alinxalinx/ACU2CG_ACU3EG_ACU4EV_ACU5EV/Pictures/ACU2CG_T.jpg

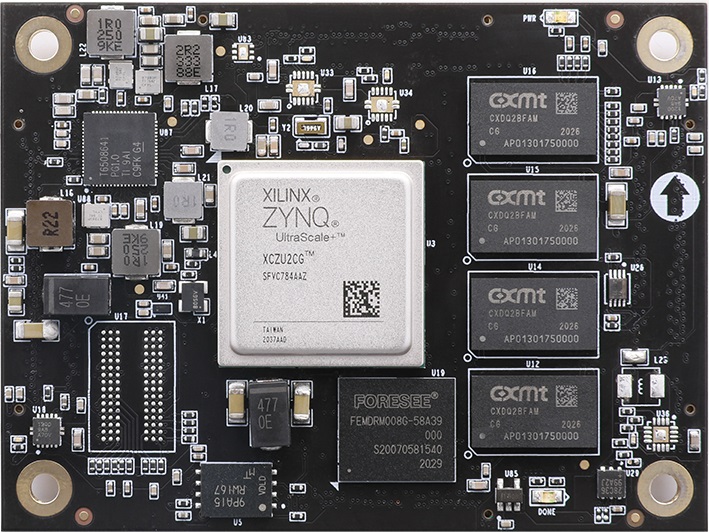
Pictures/ACU2CG_T.jpg
