alinxalinx/ACU2CG_ACU3EG_ACU4EV_ACU5EV/Pictures/ACU3EG_T.jpg

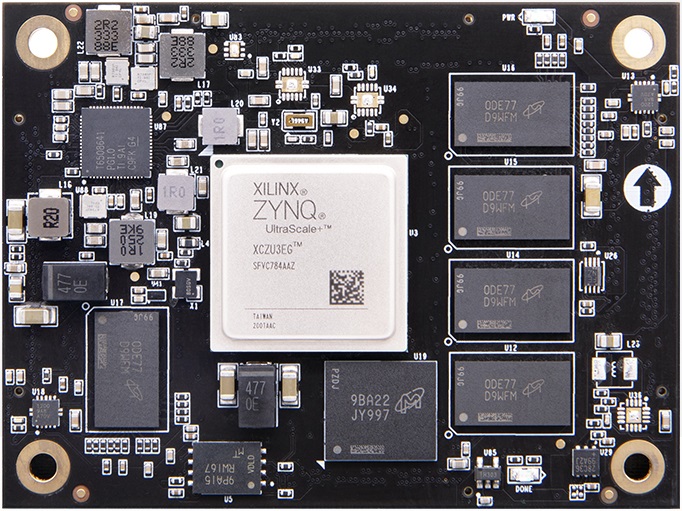
Pictures/ACU3EG_T.jpg
