alinxalinx/ACU2CG_ACU3EG_ACU4EV_ACU5EV/Pictures/ACU4EV_T.jpg

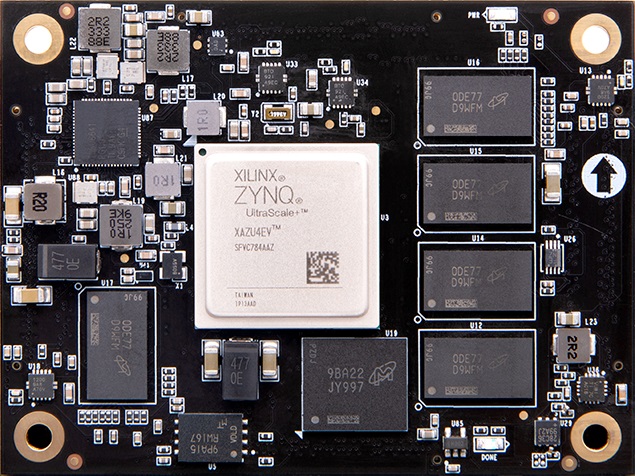
Pictures/ACU4EV_T.jpg
