alinxalinx/ACU2CG_ACU3EG_ACU4EV_ACU5EV/Trace_Lengths/IO_Length-acu2cg-2018-11-7.xls

Sheet: 505
Name | Pin Number | Singals | Min Trace Delay (ps) | Max Trace Delay (ps) | Delay(mils) | Board Length(mils) | Total Length(mils)
505_CLK0_N | F24 | PS_MGTREFCLK0N_505 | 77.181 | 77.957 | 448.3757225 | 757.06 | 1205.435723
505_CLK0_P | F23 | PS_MGTREFCLK0P_505 | 76.704 | 77.474 | 445.6011561 | 757.95 | 1203.551156
 |  |  |  |  | 0 |  | 0
505_CLK1_N | E22 | PS_MGTREFCLK1N_505 | 76.161 | 76.927 | 442.4508671 | 1082.16 | 1524.610867
505_CLK1_P | E21 | PS_MGTREFCLK1P_505 | 75.712 | 76.473 | 439.8410405 | 1083.04 | 1522.88104
 |  |  |  |  | 0 |  | 0
505_CLK2_N | C22 | PS_MGTREFCLK2N_505 | 86.316 | 87.183 | 501.4421965 | 818.31 | 1319.752197
505_CLK2_P | C21 | PS_MGTREFCLK2P_505 | 85.985 | 86.85 | 499.5231214 | 820.89 | 1320.413121
 |  |  |  |  | 0 |  | 0
505_CLK3_N | A22 | PS_MGTREFCLK3N_505 | 87.98 | 88.864 | 511.1098266 | 776.57 | 1287.679827
505_CLK3_P | A21 | PS_MGTREFCLK3P_505 | 87.717 | 88.599 | 509.583815 | 777.25 | 1286.833815
 |  |  |  |  | 0 |  | 0
505_RX0_N | F28 | PS_MGTRRXN0_505 | 98.87 | 99.864 | 574.3757225 | 1007.78 | 1582.155723
505_RX0_P | F27 | PS_MGTRRXP0_505 | 98.768 | 99.761 | 573.783237 | 1007.89 | 1581.673237
 |  |  |  |  | 0 |  | 0
505_RX1_N | D28 | PS_MGTRRXN1_505 | 111.581 | 112.702 | 648.216763 | 890.97 | 1539.186763
505_RX1_P | D27 | PS_MGTRRXP1_505 | 111.619 | 112.741 | 648.4393064 | 889.86 | 1538.299306
 |  |  |  |  |  |  | 0
505_RX2_N | B28 | PS_MGTRRXN2_505 | 105.44 | 106.5 | 612.5433526 | 676.91 | 1289.453353
505_RX2_P | B27 | PS_MGTRRXP2_505 | 105.488 | 106.548 | 612.8208092 | 676.28 | 1289.100809
 |  |  |  |  | 0 |  | 0
505_RX3_N | A26 | PS_MGTRRXN3_505 | 95.579 | 96.539 | 555.2543353 | 582.26 | 1137.514335
505_RX3_P | A25 | PS_MGTRRXP3_505 | 95.598 | 96.559 | 555.367052 | 582.16 | 1137.527052
 |  |  |  |  |  |  | 0
505_TX0_N | E26 | PS_MGTRTXN0_505 | 90.966 | 91.88 | 528.4566474 | 927.74 | 1456.196647
505_TX0_P | E25 | PS_MGTRTXP0_505 | 91.071 | 91.986 | 529.066474 | 929.02 | 1458.086474
 |  |  |  |  | 0 |  | 0
505_TX1_N | D24 | PS_MGTRTXN1_505 | 73.273 | 74.009 | 425.6705202 | 896.87 | 1322.54052
505_TX1_P | D23 | PS_MGTRTXP1_505 | 73.318 | 74.055 | 425.933526 | 897.93 | 1323.863526
 |  |  |  |  | 0 |  | 0
505_TX2_N | C26 | PS_MGTRTXN2_505 | 94.729 | 95.681 | 550.3179191 | 714.96 | 1265.277919
505_TX2_P | C25 | PS_MGTRTXP2_505 | 94.899 | 95.853 | 551.3063584 | 713.23 | 1264.536358
 |  |  |  |  | 0 |  | 0
505_TX3_N | B24 | PS_MGTRTXN3_505 | 88.328 | 89.216 | 513.132948 | 622.28 | 1135.412948
505_TX3_P | B23 | PS_MGTRTXP3_505 | 88.216 | 89.103 | 512.482659 | 621.8 | 1134.282659
 |  |  |  |  |  |  | 0
 |  |  |  |  | 0 |  | 0
差分P和N之间要做等长，等长控制在2mil以内。
差分对之间间隔尽量要远，最好要在30mil以上。
拐弯的地方走成弧形。

Sheet: BANK65
Name | Pin Number | Singals | Min Trace Delay (ps) | Max Trace Delay (ps) | Delay(mils) | Board Length(mils) | Total Length(mils)
B65_L1_N | Y8 | IO_L1N_T0L_N1_DBC_65 | 119.32 | 120.52 | 693.1791908 | 1494.61 | 2187.789191
B65_L1_P | W8 | IO_L1P_T0L_N0_DBC_65 | 118.959 | 120.155 | 691.0809249 | 1498.37 | 2189.450925
B65_L2_N | V9 | IO_L2N_T0L_N3_65 | 103.412 | 104.451 | 600.7601156 | 1560.97 | 2161.730116
B65_L2_P | U9 | IO_L2P_T0L_N2_65 | 111.487 | 112.607 | 647.6705202 | 1510.68 | 2158.35052
B65_L3_N | V8 | IO_L3N_T0L_N5_AD15N_65 | 109.619 | 110.721 | 636.8208092 | 1552.17 | 2188.990809
B65_L3_P | U8 | IO_L3P_T0L_N4_AD15P_65 | 112.8 | 113.933 | 655.2976879 | 1536.31 | 2191.607688
B65_L4_N | T8 | IO_L4N_T0U_N7_DBC_AD7N_65 | 107.023 | 108.099 | 621.7398844 | 1519.43 | 2141.169884
B65_L4_P | R8 | IO_L4P_T0U_N6_DBC_AD7P_SMBALERT_65 | 108.038 | 109.124 | 627.6358382 | 1513.3 | 2140.935838
B65_L5_N | T7 | IO_L5N_T0U_N9_AD14N_65 | 92.383 | 93.312 | 536.6907514 | 1527.99 | 2064.680751
B65_L5_P | R7 | IO_L5P_T0U_N8_AD14P_65 | 93.13 | 94.066 | 541.0289017 | 1524.2 | 2065.228902
B65_L6_N | T6 | IO_L6N_T0U_N11_AD6N_65 | 92.642 | 93.574 | 538.1965318 | 1471.18 | 2009.376532
B65_L6_P | R6 | IO_L6P_T0U_N10_AD6P_65 | 92.461 | 93.391 | 537.1445087 | 1469.03 | 2006.174509
B65_L7_N | K1 | IO_L7N_T1L_N1_QBC_AD13N_65 | 92.343 | 93.271 | 536.4566474 | 1479.54 | 2015.996647
B65_L7_P | L1 | IO_L7P_T1L_N0_QBC_AD13P_65 | 92.939 | 93.873 | 539.9190751 | 1479.45 | 2019.369075
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
B65_L24_N | H8 | IO_L24N_T3U_N11_PERSTN0_65 | 87.942 | 88.826 | 510.8901734 | 1596.2 | 2107.090173
B65_L24_P | H9 | IO_L24P_T3U_N10_PERSTN1_I2C_SDA_65 | 97.353 | 98.331 | 565.5606936 | 1543.53 | 2109.090694
差分P和N之间要做等长，等长控制在5mil以内。
B65的信号做等长，等长在300mil以内

Sheet: BANK66
Name | Pin Number | Singals | Min Trace Delay (ps) | Max Trace Delay (ps) | Delay(mils) | Board Length(mils) | Total Length(mils)
B66_L1_N | F1 | IO_L1N_T0L_N1_DBC_66 | 83.127 | 83.963 | 482.9190751 | 1164.22 | 1647.139075
B66_L1_P | G1 | IO_L1P_T0L_N0_DBC_66 | 82.163 | 82.988 | 477.3150289 | 1166.22 | 1643.535029
B66_L2_N | D1 | IO_L2N_T0L_N3_66 | 90.433 | 91.342 | 525.3612717 | 1122.8 | 1648.161272
B66_L2_P | E1 | IO_L2P_T0L_N2_66 | 87.907 | 88.791 | 510.6878613 | 1141.44 | 1652.127861
B66_L3_N | E2 | IO_L3N_T0L_N5_AD15N_66 | 94.435 | 95.384 | 548.6098266 | 1144.56 | 1693.169827
B66_L3_P | F2 | IO_L3P_T0L_N4_AD15P_66 | 101.121 | 102.138 | 587.4537572 | 1101.91 | 1689.363757
B66_L4_N | F3 | IO_L4N_T0U_N7_DBC_AD7N_66 | 77.616 | 78.396 | 450.9017341 | 1177.86 | 1628.761734
B66_L4_P | G3 | IO_L4P_T0U_N6_DBC_AD7P_66 | 78.429 | 79.217 | 455.6242775 | 1175.58 | 1631.204277
B66_L5_N | E3 | IO_L5N_T0U_N9_AD14N_66 | 80.142 | 80.947 | 465.5751445 | 1216.81 | 1682.385145
B66_L5_P | E4 | IO_L5P_T0U_N8_AD14P_66 | 88.963 | 89.857 | 516.8208092 | 1160.85 | 1677.670809
B66_L6_N | F5 | IO_L6N_T0U_N11_AD6N_66 | 82.602 | 83.432 | 479.867052 | 1156.81 | 1636.677052
B66_L6_P | G5 | IO_L6P_T0U_N10_AD6P_66 | 83.382 | 84.22 | 484.3988439 | 1154.91 | 1639.308844
B66_L7_N | B1 | IO_L7N_T1L_N1_QBC_AD13N_66 | 100.072 | 101.077 | 581.3554913 | 1113.63 | 1694.985491
B66_L7_P | C1 | IO_L7P_T1L_N0_QBC_AD13P_66 | 99.604 | 100.605 | 578.6387283 | 1118.79 | 1697.428728
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
B66_L24_N | B9 | IO_L24N_T3U_N11_66 | 78.681 | 79.472 | 457.0895954 | 1209.9 | 1666.989595
B66_L24_P | C9 | IO_L24P_T3U_N10_66 | 81.979 | 82.803 | 476.2485549 | 1189.09 | 1665.338555
差分P和N之间要做等长，等长控制在5mil以内。
B66的信号做等长，等长在300mil以内

Sheet: BANK43
Name | Pin Number | Singals | Min Trace Delay (ps) | Max Trace Delay (ps) | Delay(mils) | Board Length(mils) | Total Length(mils)
B43_L1_N | AH10 | IO_L1N_AD11N_44 | 82.803 | 83.635 | 481.0346821 | 1322.82 | 1803.854682
B43_L1_P | AG10 | IO_L1P_AD11P_44 | 81.873 | 82.696 | 475.632948 | 1332.19 | 1807.822948
B43_L2_N | AG11 | IO_L2N_AD10N_44 | 79.655 | 80.456 | 462.7485549 | 1332.8 | 1795.548555
B43_L2_P | AF11 | IO_L2P_AD10P_44 | 79.959 | 80.762 | 464.5115607 | 1335.1 | 1799.611561
B43_L3_N | AH11 | IO_L3N_AD9N_44 | 90.297 | 91.204 | 524.5693642 | 1255.63 | 1780.199364
B43_L3_P | AH12 | IO_L3P_AD9P_44 | 89.882 | 90.785 | 522.1589595 | 1259.38 | 1781.53896
B43_L4_N | AF10 | IO_L4N_AD8N_44 | 82.631 | 83.462 | 480.0375723 | 1324.7 | 1804.737572
B43_L4_P | AE10 | IO_L4P_AD8P_44 | 82.591 | 83.421 | 479.8034682 | 1328.86 | 1808.663468
B43_L5_N | AF12 | IO_L5N_HDGC_AD7N_44 | 82.302 | 83.129 | 478.1242775 | 1304.05 | 1782.174277
B43_L5_P | AE12 | IO_L5P_HDGC_AD7P_44 | 81.539 | 82.358 | 473.6907514 | 1303.55 | 1777.240751
B43_L6_N | AD12 | IO_L6N_HDGC_AD6N_44 | 76.561 | 77.331 | 444.7745665 | 1354.56 | 1799.334566
B43_L6_P | AC12 | IO_L6P_HDGC_AD6P_44 | 76.298 | 77.064 | 443.2427746 | 1360.43 | 1803.672775
B43_L7_N | AD10 | IO_L7N_HDGC_AD5N_44 | 78.359 | 79.147 | 455.2196532 | 1372.25 | 1827.469653
B43_L7_P | AD11 | IO_L7P_HDGC_AD5P_44 | 77.837 | 78.62 | 452.1878613 | 1367.57 | 1819.757861
B43_L8_N | AC11 | IO_L8N_HDGC_AD4N_44 | 66.387 | 67.054 | 385.6676301 | 1481.22 | 1866.88763
B43_L8_P | AB11 | IO_L8P_HDGC_AD4P_44 | 65.646 | 66.305 | 381.3612717 | 1483.28 | 1864.641272
B43_L9_N | AA10 | IO_L9N_AD3N_44 | 61.946 | 62.568 | 359.867052 | 1417.77 | 1777.637052
B43_L9_P | AA11 | IO_L9P_AD3P_44 | 60.539 | 61.148 | 351.6965318 | 1426.03 | 1777.726532
B43_L10_N | Y10 | IO_L10N_AD2N_44 | 67.472 | 68.15 | 391.9710983 | 1397.28 | 1789.251098
B43_L10_P | W10 | IO_L10P_AD2P_44 | 66.633 | 67.302 | 387.0953757 | 1398.41 | 1785.505376
B43_L11_N | AA8 | IO_L11N_AD1N_44 | 65.845 | 66.507 | 382.5202312 | 1482.16 | 1864.680231
B43_L11_P | Y9 | IO_L11P_AD1P_44 | 53.413 | 53.95 | 310.2976879 | 1530.1 | 1840.397688
B43_L12_N | AB9 | IO_L12N_AD0N_44 | 74.171 | 74.917 | 430.8901734 | 1384.75 | 1815.640173
B43_L12_P | AB10 | IO_L12P_AD0P_44 | 78.497 | 79.286 | 456.0202312 | 1363.83 | 1819.850231
差分P和N之间要做等长，等长控制在5mil以内。
B43的信号做等长，等长在300mil以内
 | 43
 | 43

Sheet: BANK44
Name | Pin Number | Singals | Min Trace Delay (ps) | Max Trace Delay (ps) | Delay(mils) | Board Length(mils) | Total Length(mils)
B44_L1_N | AE14 | IO_L1N_AD15N_24 | 75.571 | 76.331 | 439.0231214 | 1180.35 | 1619.373121
B44_L1_P | AE15 | IO_L1P_AD15P_24 | 74.638 | 75.389 | 433.6040462 | 1181.21 | 1614.814046
B44_L2_N | AH14 | IO_L2N_AD14N_24 | 82.123 | 82.948 | 477.083815 | 1158.27 | 1635.353815
B44_L2_P | AG14 | IO_L2P_AD14P_24 | 79.397 | 80.195 | 461.2485549 | 1173.65 | 1634.898555
B44_L3_N | AH13 | IO_L3N_AD13N_24 | 87.652 | 88.533 | 509.2052023 | 1107.32 | 1616.525202
B44_L3_P | AG13 | IO_L3P_AD13P_24 | 81.761 | 82.582 | 474.9797688 | 1139.05 | 1614.029769
B44_L4_N | AF13 | IO_L4N_AD12N_24 | 80.353 | 81.161 | 466.8034682 | 1124.3 | 1591.103468
B44_L4_P | AE13 | IO_L4P_AD12P_24 | 80.287 | 81.094 | 466.4190751 | 1129.25 | 1595.669075
B44_L5_N | AD14 | IO_L5N_HDGC_24 | 76.954 | 77.728 | 447.0578035 | 1177.94 | 1624.997803
B44_L5_P | AD15 | IO_L5P_HDGC_24 | 77.276 | 78.052 | 448.9248555 | 1175.9 | 1624.824855
B44_L6_N | AC13 | IO_L6N_HDGC_24 | 70.342 | 71.049 | 408.6445087 | 1250.87 | 1659.514509
B44_L6_P | AC14 | IO_L6P_HDGC_24 | 69.37 | 70.067 | 402.9971098 | 1259.62 | 1662.61711
B44_L7_N | AB13 | IO_L7N_HDGC_24 | 59.409 | 60.006 | 345.1300578 | 1382.59 | 1727.720058
B44_L7_P | AA13 | IO_L7P_HDGC_24 | 58.983 | 59.576 | 342.6560694 | 1386.1 | 1728.756069
B44_L8_N | AB14 | IO_L8N_HDGC_24 | 74.644 | 75.394 | 433.6358382 | 1198.13 | 1631.765838
B44_L8_P | AB15 | IO_L8P_HDGC_24 | 75.6 | 76.36 | 439.1907514 | 1197.49 | 1636.680751
B44_L9_N | W13 | IO_L9N_AD11N_24 | 58.488 | 59.076 | 339.7803468 | 1255.27 | 1595.050347
B44_L9_P | W14 | IO_L9P_AD11P_24 | 63.725 | 64.366 | 370.2052023 | 1221.17 | 1591.375202
B44_L10_N | Y13 | IO_L10N_AD10N_24 | 70.875 | 71.587 | 411.7398844 | 1250.94 | 1662.679884
B44_L10_P | Y14 | IO_L10P_AD10P_24 | 71.726 | 72.447 | 416.6849711 | 1247.51 | 1664.194971
B44_L11_N | W11 | IO_L11N_AD9N_24 | 50.987 | 51.499 | 296.2023121 | 1386.16 | 1682.362312
B44_L11_P | W12 | IO_L11P_AD9P_24 | 53.294 | 53.829 | 309.6040462 | 1368.62 | 1678.224046
B44_L12_N | AA12 | IO_L12N_AD8N_24 | 63.684 | 64.324 | 369.9653179 | 1253.6 | 1623.565318
B44_L12_P | Y12 | IO_L12P_AD8P_24 | 64.23 | 64.875 | 373.1358382 | 1248.76 | 1621.895838
差分P和N之间要做等长，等长控制在5mil以内。
B44的信号做等长，等长在300mil以内

Sheet: BANK45
Name | Pin Number | Singals | Min Trace Delay (ps) | Max Trace Delay (ps) | Delay(mils) | Board Length(mils) | Total Length(mils)
B45_L4_N | H12 | IO_L4N_AD12N_25 | 80.279 | 81.086 | 466.3728324 | 811.18 | 1277.552832
B45_L4_P | J12 | IO_L4P_AD12P_25 | 80.864 | 81.676 | 469.7687861 | 806.21 | 1275.978786
B45_L5_N | F10 | IO_L5N_HDGC_25 | 92.468 | 93.398 | 537.1849711 | 765.91 | 1303.094971
B45_L5_P | G11 | IO_L5P_HDGC_25 | 91.611 | 92.532 | 532.2052023 | 766.64 | 1298.845202
B45_L6_N | F11 | IO_L6N_HDGC_25 | 81.398 | 82.216 | 472.8728324 | 932.48 | 1405.352832
B45_L6_P | F12 | IO_L6P_HDGC_25 | 81.671 | 82.492 | 474.4595376 | 934.74 | 1409.199538
B45_L9_N | B10 | IO_L9N_AD11N_25 | 102.69 | 103.722 | 596.566474 | 878.91 | 1475.476474
B45_L9_P | C11 | IO_L9P_AD11P_25 | 100.155 | 101.162 | 581.8410405 | 890.77 | 1472.61104
B45_L10_N | A10 | IO_L10N_AD10N_25 | 108.64 | 109.731 | 631.1300578 | 839.07 | 1470.200058
B45_L10_P | B11 | IO_L10P_AD10P_25 | 107.734 | 108.816 | 625.867052 | 846.15 | 1472.017052
B45_L11_N | A11 | IO_L11N_AD9N_25 | 106.912 | 107.987 | 621.0953757 | 868.32 | 1489.415376
B45_L11_P | A12 | IO_L11P_AD9P_25 | 103.22 | 104.258 | 599.6473988 | 892.11 | 1491.757399
B45_L12_N | C12 | IO_L12N_AD8N_25 | 92.837 | 93.77 | 539.3265896 | 937.33 | 1476.65659
B45_L12_P | D12 | IO_L12P_AD8P_25 | 92.907 | 93.841 | 539.734104 | 934.96 | 1474.694104
差分P和N之间要做等长，等长控制在5mil以内。
B45的信号做等长，等长在300mil以内

Sheet: BANK46
Name | Pin Number | Singals | Min Trace Delay (ps) | Max Trace Delay (ps) | Delay(mils) | Board Length(mils) | Total Length(mils)
B46_L1_N | A15 | IO_L1N_AD11N_26 | 100.887 | 101.901 | 586.0924855 | 958.03 | 1544.122486
B46_L1_P | B15 | IO_L1P_AD11P_26 | 100.101 | 101.107 | 581.5260116 | 972.48 | 1554.006012
B46_L2_N | A14 | IO_L2N_AD10N_26 | 98.438 | 99.427 | 571.8641618 | 853.41 | 1425.274162
B46_L2_P | B14 | IO_L2P_AD10P_26 | 96.065 | 97.03 | 558.0780347 | 864.93 | 1423.008035
B46_L3_N | A13 | IO_L3N_AD9N_26 | 98.945 | 99.939 | 574.8092486 | 826.95 | 1401.759249
B46_L3_P | B13 | IO_L3P_AD9P_26 | 101.116 | 102.132 | 587.4219653 | 816.92 | 1404.341965
B46_L4_N | C13 | IO_L4N_AD8N_26 | 92.533 | 93.463 | 537.5606936 | 911.28 | 1448.840694
B46_L4_P | C14 | IO_L4P_AD8P_26 | 91.545 | 92.465 | 531.8208092 | 914.08 | 1445.900809
B46_L5_N | D14 | IO_L5N_HDGC_AD7N_26 | 79.098 | 79.893 | 459.5115607 | 1004.33 | 1463.841561
B46_L5_P | D15 | IO_L5P_HDGC_AD7P_26 | 79.702 | 80.503 | 463.0202312 | 1004.36 | 1467.380231
B46_L6_N | E13 | IO_L6N_HDGC_AD6N_26 | 75.113 | 75.868 | 436.3612717 | 1008.14 | 1444.501272
B46_L6_P | E14 | IO_L6P_HDGC_AD6P_26 | 74.392 | 75.139 | 432.1705202 | 1011.91 | 1444.08052
B46_L7_N | F13 | IO_L7N_HDGC_AD5N_26 | 64.705 | 65.355 | 375.8959538 | 1113.51 | 1489.405954
B46_L7_P | G13 | IO_L7P_HDGC_AD5P_26 | 64.208 | 64.853 | 373.0086705 | 1112.32 | 1485.328671
B46_L9_N | G14 | IO_L9N_AD3N_26 | 53.56 | 54.099 | 311.1531792 | 1133.96 | 1445.113179
B46_L9_P | G15 | IO_L9P_AD3P_26 | 57.941 | 58.524 | 336.6040462 | 1113.47 | 1450.074046
B46_L10_N | H13 | IO_L10N_AD2N_26 | 75.143 | 75.899 | 436.5375723 | 1104.12 | 1540.657572
B46_L10_P | H14 | IO_L10P_AD2P_26 | 74.198 | 74.944 | 431.0462428 | 1114.53 | 1545.576243
B46_L11_N | J14 | IO_L11N_AD1N_26 | 60.518 | 61.127 | 351.5751445 | 1154.18 | 1505.755145
B46_L11_P | K14 | IO_L11P_AD1P_26 | 70.406 | 71.114 | 409.017341 | 1092.08 | 1501.097341
B46_L12_N | L13 | IO_L12N_AD0N_26 | 60.113 | 60.717 | 349.2196532 | 1289.57 | 1638.789653
B46_L12_P | L14 | IO_L12P_AD0P_26 | 60.632 | 61.241 | 352.234104 | 1282.88 | 1635.114104
差分P和N之间要做等长，等长控制在5mil以内。
B46的信号做等长，等长在300mil以内

Sheet: MIO
Name | Pin Number | Singals | Min Trace Delay (ps) | Max Trace Delay (ps) | Delay(mils) | Board Length(mils) | Total Length(mils)
AB19 | PS_MIO24_500 | 96.377 | 97.345 | 97.345 | 562.6878613 | 1596.32 | 2159.007861
AB21 | PS_MIO25_500 | 114.475 | 115.626 | 115.626 | 668.3583815 | 1503.58 | 2171.938382
L15 | PS_MIO26_501 | 39.916 | 40.317 | 40.317 | 233.0462428 | 1769.09 | 2002.136243
J15 | PS_MIO27_501 | 41.194 | 41.608 | 41.608 | 240.5086705 | 3087.21 | 3327.718671
K15 | PS_MIO28_501 | 39.512 | 39.909 | 39.909 | 230.6878613 | 3320.61 | 3551.297861
G16 | PS_MIO29_501 | 53.03 | 53.563 | 53.563 | 309.6127168 | 1997.65 | 2307.262717
F16 | PS_MIO30_501 | 50.496 | 51.003 | 51.003 | 294.8150289 | 2596.71 | 2891.525029
H16 | PS_MIO31_501 | 39.919 | 40.32 | 40.32 | 233.0635838 | 2702.23 | 2935.293584
J16 | PS_MIO32_501 | 40.336 | 40.741 | 40.741 | 235.4971098 | 2532.54 | 2768.03711
L16 | PS_MIO33_501 | 50.412 | 50.918 | 50.918 | 294.3236994 | 1924.77 | 2219.093699
L17 | PS_MIO34_501 | 44.763 | 45.213 | 45.213 | 261.3468208 | 1911.41 | 2172.756821
H17 | PS_MIO35_501 | 47.83 | 48.31 | 48.31 | 279.2485549 | 2012.43 | 2291.678555
K17 | PS_MIO36_501 | 39.972 | 40.374 | 40.374 | 233.3757225 | 1687.97 | 1921.345723
J17 | PS_MIO37_501 | 40.877 | 41.288 | 41.288 | 238.6589595 | 1603.17 | 1841.82896
H18 | PS_MIO38_501 | 49.45 | 49.947 | 49.947 | 288.7109827 | 2468.78 | 2757.490983
H19 | PS_MIO39_501 | 54.436 | 54.983 | 54.983 | 317.8208092 | 2272.48 | 2590.300809
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
A19 | PS_MIO75_502 | 79.376 | 80.174 | 80.174 | 463.433526 | 2813.01 | 3276.443526
B20 | PS_MIO76_502 | 78.207 | 78.993 | 78.993 | 456.6069364 | 2087.84 | 2544.446936
F20 | PS_MIO77_502 | 51.712 | 52.231 | 52.231 | 301.9132948 | 2148.05 | 2449.963295
 |  |  | F20 | PS_MIO77_502 | 51.712 | 52.231
