alinxalinx/ACU2CG_ACU3EG_ACU4EV_ACU5EV/Trace_Lengths/IO_Length-xczu4ev-2018-11-5.xls

Sheet: 224
Name | Pin Number | Singals | Min Trace Delay (ps) | Max Trace Delay (ps) | Delay(mils) | Board Length(mils) | Total Length(mils)
224_CLK0_N | Y5 | MGTREFCLK0N_224 | 48.618 | 49.106 | 282.4393064 | 829.5 | 1111.939306
224_CLK0_P | Y6 | MGTREFCLK0P_224 | 48.543 | 49.03 | 282.0028902 | 829.69 | 1111.69289
 |  |  |  |  | 0 |  | 0
224_CLK1_N | V5 | MGTREFCLK1N_224 | 43.582 | 44.02 | 253.1849711 | 1119.45 | 1372.634971
224_CLK1_P | V6 | MGTREFCLK1P_224 | 43.647 | 44.086 | 253.5635838 | 1118.59 | 1372.153584
 |  |  |  |  | 0 |  | 0
224_RX0_N | Y1 | MGTHRXN0_224 | 62.229 | 62.855 | 361.5144509 | 1094.25 | 1455.764451
224_RX0_P | Y2 | MGTHRXP0_224 | 62.36 | 62.987 | 362.2745665 | 1095.8 | 1458.074566
 |  |  |  |  | 0 |  | 0
224_RX1_N | V1 | MGTHRXN1_224 | 56.432 | 56.999 | 327.8352601 | 1130.01 | 1457.84526
224_RX1_P | V2 | MGTHRXP1_224 | 56.58 | 57.148 | 328.6936416 | 1130.43 | 1459.123642
 |  |  |  |  | 0 |  | 0
224_RX2_N | T1 | MGTHRXN2_224 | 51.766 | 52.286 | 300.7283237 | 1231.91 | 1532.638324
224_RX2_P | T2 | MGTHRXP2_224 | 51.864 | 52.386 | 301.300578 | 1232.07 | 1533.370578
 |  |  |  |  |  |  | 0
224_RX3_N | P1 | MGTHRXN3_224 | 50.196 | 50.7 | 291.6069364 | 1342.63 | 1634.236936
224_RX3_P | P2 | MGTHRXP3_224 | 50.195 | 50.699 | 291.6011561 | 1341.1 | 1632.701156
 |  |  |  |  |  |  | 0
224_TX0_N | W3 | MGTHTXN0_224 | 38.589 | 38.976 | 224.1763006 | 921.03 | 1145.206301
224_TX0_P | W4 | MGTHTXP0_224 | 38.683 | 39.072 | 224.7254335 | 921.47 | 1146.195434
 |  |  |  |  |  |  | 0
224_TX1_N | U3 | MGTHTXN1_224 | 41.022 | 41.434 | 238.3121387 | 990.54 | 1228.852139
224_TX1_P | U4 | MGTHTXP1_224 | 41.065 | 41.477 | 238.5606936 | 988.23 | 1226.790694
 |  |  |  |  | 0 |  | 0
224_TX2_N | R3 | MGTHTXN2_224 | 34.095 | 34.438 | 198.0722543 | 1077.08 | 1275.152254
224_TX2_P | R4 | MGTHTXP2_224 | 34.16 | 34.503 | 198.4479769 | 1075.64 | 1274.087977
 |  |  |  |  | 0 |  | 0
224_TX3_N | N3 | MGTHTXN3_224 | 33.087 | 33.42 | 192.216763 | 1218.44 | 1410.656763
224_TX3_P | N4 | MGTHTXP3_224 | 33.05 | 33.382 | 192 | 1218.56 | 1410.56

Sheet: 505
Name | Pin Number | Singals | Min Trace Delay (ps) | Max Trace Delay (ps) | Delay(mils) | Board Length(mils) | Total Length(mils)
505_CLK0_N | F24 | PS_MGTREFCLK0N_505 | 75.693 | 76.453 | 439.7283237 | 764.24 | 1203.968324
505_CLK0_P | F23 | PS_MGTREFCLK0P_505 | 75.735 | 76.496 | 439.9739884 | 763.54 | 1203.513988
 |  |  |  |  | 0 |  | 0
505_CLK1_N | E22 | PS_MGTREFCLK1N_505 | 76.285 | 77.052 | 443.1705202 | 989.96 | 1433.13052
505_CLK1_P | E21 | PS_MGTREFCLK1P_505 | 76.363 | 77.13 | 443.6213873 | 991.02 | 1434.641387
 |  |  |  |  | 0 |  | 0
505_CLK2_N | C22 | PS_MGTREFCLK2N_505 | 89.666 | 90.568 | 520.9075145 | 788.59 | 1309.497514
505_CLK2_P | C21 | PS_MGTREFCLK2P_505 | 89.191 | 90.088 | 518.1473988 | 791.15 | 1309.297399
 |  |  |  |  | 0 |  | 0
505_CLK3_N | A22 | PS_MGTREFCLK3N_505 | 91.223 | 92.14 | 529.9508671 | 771.67 | 1301.620867
505_CLK3_P | A21 | PS_MGTREFCLK3P_505 | 91.48 | 92.399 | 531.4421965 | 769.27 | 1300.712197
 |  |  |  |  | 0 |  | 0
505_RX0_N | F28 | PS_MGTRRXN0_505 | 75.37 | 76.128 | 437.8554913 | 753.4 | 1191.255491
505_RX0_P | F27 | PS_MGTRRXP0_505 | 75.437 | 76.195 | 438.2427746 | 752.57 | 1190.812775
 |  |  |  |  | 0 |  | 0
505_RX1_N | D28 | PS_MGTRRXN1_505 | 70.515 | 71.224 | 409.650289 | 710.74 | 1120.390289
505_RX1_P | D27 | PS_MGTRRXP1_505 | 70.609 | 71.318 | 410.1936416 | 710.21 | 1120.403642
 |  |  |  |  |  |  | 0
505_RX2_N | B28 | PS_MGTRRXN2_505 | 90.74 | 91.652 | 527.1445087 | 822.28 | 1349.424509
505_RX2_P | B27 | PS_MGTRRXP2_505 | 90.663 | 91.575 | 526.699422 | 825.5 | 1352.199422
 |  |  |  |  | 0 |  | 0
505_RX3_N | A26 | PS_MGTRRXN3_505 | 82.588 | 83.418 | 479.7861272 | 772.7 | 1252.486127
505_RX3_P | A25 | PS_MGTRRXP3_505 | 82.444 | 83.272 | 478.9479769 | 773.78 | 1252.727977
 |  |  |  |  |  |  | 0
505_TX0_N | E26 | PS_MGTRTXN0_505 | 75.492 | 76.251 | 438.5635838 | 685.76 | 1124.323584
505_TX0_P | E25 | PS_MGTRTXP0_505 | 75.352 | 76.109 | 437.7485549 | 687.31 | 1125.058555
 |  |  |  |  | 0 |  | 0
505_TX1_N | D24 | PS_MGTRTXN1_505 | 62.781 | 63.412 | 364.7196532 | 824.56 | 1189.279653
505_TX1_P | D23 | PS_MGTRTXP1_505 | 62.757 | 63.388 | 364.5809249 | 825.16 | 1189.740925
 |  |  |  |  | 0 |  | 0
505_TX2_N | C26 | PS_MGTRTXN2_505 | 84.58 | 85.43 | 491.3583815 | 888.7 | 1380.058382
505_TX2_P | C25 | PS_MGTRTXP2_505 | 84.588 | 85.438 | 491.4046243 | 887.69 | 1379.094624
 |  |  |  |  | 0 |  | 0
505_TX3_N | B24 | PS_MGTRTXN3_505 | 66.489 | 67.158 | 386.2630058 | 800.45 | 1186.713006
505_TX3_P | B23 | PS_MGTRTXP3_505 | 66.549 | 67.218 | 386.6098266 | 799.12 | 1185.729827
 |  |  |  |  |  |  | 0
 |  |  |  |  | 0 |  | 0
差分P和N之间要做等长，等长控制在2mil以内。
差分对之间间隔尽量要远，最好要在30mil以上。
拐弯的地方走成弧形。

Sheet: BANK65
Name | Pin Number | Singals | Min Trace Delay (ps) | Max Trace Delay (ps) | Delay(mils) | Board Length(mils) | Total Length(mils)
B65_L1_N | Y8 | IO_L1N_T0L_N1_DBC_65 | 79.758 | 80.56 | 463.3468208 | 1566.81 | 2030.156821
B65_L1_P | W8 | IO_L1P_T0L_N0_DBC_65 | 79.677 | 80.477 | 462.8728324 | 1570.58 | 2033.452832
B65_L2_N | V9 | IO_L2N_T0L_N3_65 | 75.998 | 76.762 | 441.5028902 | 1601.69 | 2043.19289
B65_L2_P | U9 | IO_L2P_T0L_N2_65 | 72.374 | 73.102 | 420.4508671 | 1619.24 | 2039.690867
B65_L3_N | V8 | IO_L3N_T0L_N5_AD15N_65 | 74.039 | 74.783 | 430.1213873 | 1599.85 | 2029.971387
B65_L3_P | U8 | IO_L3P_T0L_N4_AD15P_65 | 71.625 | 72.345 | 416.0982659 | 1609.92 | 2026.018266
B65_L4_N | T8 | IO_L4N_T0U_N7_DBC_AD7N_65 | 73.164 | 73.899 | 425.0375723 | 1598.09 | 2023.127572
B65_L4_P | R8 | IO_L4P_T0U_N6_DBC_AD7P_SMBALERT_65 | 72.564 | 73.293 | 421.5520231 | 1601.4 | 2022.952023
B65_L5_N | T7 | IO_L5N_T0U_N9_AD14N_65 | 72.939 | 73.672 | 423.7312139 | 1607.11 | 2030.841214
B65_L5_P | R7 | IO_L5P_T0U_N8_AD14P_65 | 73.26 | 73.997 | 425.5982659 | 1601.11 | 2026.708266
B65_L6_N | T6 | IO_L6N_T0U_N11_AD6N_65 | 85.559 | 86.419 | 497.0462428 | 1512.04 | 2009.086243
B65_L6_P | R6 | IO_L6P_T0U_N10_AD6P_65 | 80.671 | 81.482 | 468.650289 | 1537.06 | 2005.710289
B65_L7_N | K1 | IO_L7N_T1L_N1_QBC_AD13N_65 | 113.934 | 115.079 | 661.8872832 | 1476.04 | 2137.927283
B65_L7_P | L1 | IO_L7P_T1L_N0_QBC_AD13P_65 | 112.71 | 113.842 | 654.7745665 | 1481.68 | 2136.454566
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
B65_L24_N | H8 | IO_L24N_T3U_N11_PERSTN0_65 | 73.316 | 74.053 | 425.9219653 | 1584.42 | 2010.341965
B65_L24_P | H9 | IO_L24P_T3U_N10_PERSTN1_I2C_SDA_65 | 72.575 | 73.304 | 421.6156069 | 1587.44 | 2009.055607
差分P和N之间要做等长，等长控制在5mil以内。
B65的信号做等长，等长在300mil以内

Sheet: BANK66
Name | Pin Number | Singals | Min Trace Delay (ps) | Max Trace Delay (ps) | Delay(mils) | Board Length(mils) | Total Length(mils)
B66_L1_N | F1 | IO_L1N_T0L_N1_DBC_66 | 114.902 | 116.057 | 667.5115607 | 1210.04 | 1877.551561
B66_L1_P | G1 | IO_L1P_T0L_N0_DBC_66 | 114.751 | 115.904 | 666.632948 | 1212.58 | 1879.212948
B66_L2_N | D1 | IO_L2N_T0L_N3_66 | 129.383 | 130.684 | 751.6387283 | 1138.42 | 1890.058728
B66_L2_P | E1 | IO_L2P_T0L_N2_66 | 125.538 | 126.8 | 729.300578 | 1162.65 | 1891.950578
B66_L3_N | E2 | IO_L3N_T0L_N5_AD15N_66 | 115.304 | 116.463 | 669.8468208 | 1082.54 | 1752.386821
B66_L3_P | F2 | IO_L3P_T0L_N4_AD15P_66 | 111.364 | 112.483 | 646.9566474 | 1102.6 | 1749.556647
B66_L4_N | F3 | IO_L4N_T0U_N7_DBC_AD7N_66 | 104.969 | 106.024 | 609.8063584 | 1175.72 | 1785.526358
B66_L4_P | G3 | IO_L4P_T0U_N6_DBC_AD7P_66 | 105.652 | 106.714 | 613.7745665 | 1173.45 | 1787.224566
B66_L5_N | E3 | IO_L5N_T0U_N9_AD14N_66 | 107.789 | 108.872 | 626.1878613 | 1178.56 | 1804.747861
B66_L5_P | E4 | IO_L5P_T0U_N8_AD14P_66 | 107.355 | 108.434 | 623.6676301 | 1182.83 | 1806.49763
B66_L6_N | F5 | IO_L6N_T0U_N11_AD6N_66 | 103.64 | 104.681 | 602.083815 | 1141.51 | 1743.593815
B66_L6_P | G5 | IO_L6P_T0U_N10_AD6P_66 | 102.626 | 103.657 | 596.1936416 | 1144.22 | 1740.413642
B66_L7_N | B1 | IO_L7N_T1L_N1_QBC_AD13N_66 | 124.89 | 126.145 | 725.5346821 | 1083.02 | 1808.554682
B66_L7_P | C1 | IO_L7P_T1L_N0_QBC_AD13P_66 | 123.859 | 125.104 | 719.5462428 | 1089.29 | 1808.836243
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
B66_L24_N | B9 | IO_L24N_T3U_N11_66 | 87.479 | 88.358 | 508.199422 | 1154.93 | 1663.129422
B66_L24_P | C9 | IO_L24P_T3U_N10_66 | 84.68 | 85.531 | 491.9393064 | 1168.12 | 1660.059306
差分P和N之间要做等长，等长控制在5mil以内。
B66的信号做等长，等长在300mil以内

Sheet: BANK43
Name | Pin Number | Singals | Min Trace Delay (ps) | Max Trace Delay (ps) | Delay(mils) | Board Length(mils) | Total Length(mils)
B43_L1_N | AH10 | IO_L1N_AD11N_43 | 95.669 | 96.631 | 555.7803468 | 1321.38 | 1877.160347
B43_L1_P | AG10 | IO_L1P_AD11P_43 | 91.987 | 92.912 | 534.3901734 | 1339.46 | 1873.850173
B43_L2_N | AG11 | IO_L2N_AD10N_43 | 89.974 | 90.878 | 522.6936416 | 1320.56 | 1843.253642
B43_L2_P | AF11 | IO_L2P_AD10P_43 | 86.879 | 87.752 | 504.7138728 | 1336.95 | 1841.663873
B43_L3_N | AH11 | IO_L3N_AD9N_43 | 96.652 | 97.623 | 561.4884393 | 1252.39 | 1813.878439
B43_L3_P | AH12 | IO_L3P_AD9P_43 | 95.435 | 96.395 | 554.4219653 | 1256.14 | 1810.561965
B43_L4_N | AF10 | IO_L4N_AD8N_43 | 93.723 | 94.665 | 544.4739884 | 1106.54 | 1651.013988
B43_L4_P | AE10 | IO_L4P_AD8P_43 | 92.071 | 92.996 | 534.8757225 | 1120.58 | 1655.455723
B43_L5_N | AF12 | IO_L5N_HDGC_AD7N_43 | 96.694 | 97.666 | 561.734104 | 990.24 | 1551.974104
B43_L5_P | AE12 | IO_L5P_HDGC_AD7P_43 | 97.48 | 98.459 | 566.2976879 | 984.64 | 1550.937688
B43_L6_N | AD12 | IO_L6N_HDGC_AD6N_43 | 88.162 | 89.048 | 512.1676301 | 1383.5 | 1895.66763
B43_L6_P | AC12 | IO_L6P_HDGC_AD6P_43 | 87.997 | 88.882 | 511.2109827 | 1386.03 | 1897.240983
B43_L7_N | AD10 | IO_L7N_HDGC_AD5N_43 | 96.997 | 97.971 | 563.4913295 | 1401.13 | 1964.621329
B43_L7_P | AD11 | IO_L7P_HDGC_AD5P_43 | 98.089 | 99.074 | 569.8352601 | 1396.45 | 1966.28526
B43_L8_N | AC11 | IO_L8N_HDGC_AD4N_43 | 74.931 | 75.684 | 435.3034682 | 1530.85 | 1966.153468
B43_L8_P | AB11 | IO_L8P_HDGC_AD4P_43 | 75.509 | 76.268 | 438.6618497 | 1529.86 | 1968.52185
B43_L9_N | AA10 | IO_L9N_AD3N_43 | 74.292 | 75.039 | 431.5924855 | 1425.34 | 1856.932486
B43_L9_P | AA11 | IO_L9P_AD3P_43 | 70.287 | 70.993 | 408.3236994 | 1445.09 | 1853.413699
B43_L10_N | Y10 | IO_L10N_AD2N_43 | 76.608 | 77.378 | 445.0462428 | 1416.09 | 1861.136243
B43_L10_P | W10 | IO_L10P_AD2P_43 | 77.905 | 78.688 | 452.5809249 | 1409.61 | 1862.190925
B43_L11_N | AA8 | IO_L11N_AD1N_43 | 88.892 | 89.786 | 516.4104046 | 1193.11 | 1709.520405
B43_L11_P | Y9 | IO_L11P_AD1P_43 | 81.745 | 82.566 | 474.8872832 | 1234.58 | 1709.467283
B43_L12_N | AB9 | IO_L12N_AD0N_43 | 90.812 | 91.725 | 527.5635838 | 1358.27 | 1885.833584
B43_L12_P | AB10 | IO_L12P_AD0P_43 | 86.323 | 87.191 | 501.4855491 | 1379.73 | 1881.215549
差分P和N之间要做等长，等长控制在5mil以内。
B43的信号做等长，等长在300mil以内
 | 43
 | 43

Sheet: BANK44
Name | Pin Number | Singals | Min Trace Delay (ps) | Max Trace Delay (ps) | Delay(mils) | Board Length(mils) | Total Length(mils)
B44_L1_N | AE14 | IO_L1N_AD15N_44 | 87.001 | 87.875 | 505.4219653 | 1191.13 | 1696.551965
B44_L1_P | AE15 | IO_L1P_AD15P_44 | 87.031 | 87.905 | 505.5953757 | 1192.45 | 1698.045376
B44_L2_N | AH14 | IO_L2N_AD14N_44 | 110.661 | 111.773 | 642.8728324 | 1172.27 | 1815.142832
B44_L2_P | AG14 | IO_L2P_AD14P_44 | 114.378 | 115.527 | 664.4653179 | 1152.72 | 1817.185318
B44_L3_N | AH13 | IO_L3N_AD13N_44 | 104.329 | 105.377 | 606.0867052 | 1129.36 | 1735.446705
B44_L3_P | AG13 | IO_L3P_AD13P_44 | 102.896 | 103.93 | 597.7630058 | 1141.9 | 1739.663006
B44_L4_N | AF13 | IO_L4N_AD12N_44 | 95.35 | 96.309 | 553.9277457 | 1146.2 | 1700.127746
B44_L4_P | AE13 | IO_L4P_AD12P_44 | 97.995 | 98.98 | 569.2919075 | 1133.65 | 1702.941908
B44_L5_N | AD14 | IO_L5N_HDGC_44 | 95.032 | 95.987 | 552.0780347 | 1177.95 | 1730.028035
B44_L5_P | AD15 | IO_L5P_HDGC_44 | 95.666 | 96.627 | 555.7601156 | 1175.12 | 1730.880116
B44_L6_N | AC13 | IO_L6N_HDGC_44 | 86.479 | 87.348 | 502.3901734 | 1256.26 | 1758.650173
B44_L6_P | AC14 | IO_L6P_HDGC_44 | 87.105 | 87.981 | 506.0289017 | 1249.53 | 1755.558902
B44_L7_N | AB13 | IO_L7N_HDGC_44 | 80.469 | 81.277 | 467.4739884 | 1430.49 | 1897.963988
B44_L7_P | AA13 | IO_L7P_HDGC_44 | 79.641 | 80.442 | 462.6676301 | 1433.46 | 1896.12763
B44_L8_N | AB14 | IO_L8N_HDGC_44 | 68.691 | 69.381 | 399.0520231 | 1196.44 | 1595.492023
B44_L8_P | AB15 | IO_L8P_HDGC_44 | 68.207 | 68.892 | 396.2398844 | 1195.55 | 1591.789884
B44_L9_N | W13 | IO_L9N_AD11N_44 | 59.792 | 60.393 | 347.3554913 | 1249.51 | 1596.865491
B44_L9_P | W14 | IO_L9P_AD11P_44 | 57.54 | 58.118 | 334.2716763 | 1259.51 | 1593.781676
B44_L10_N | Y13 | IO_L10N_AD10N_44 | 73.326 | 74.063 | 425.9797688 | 1257.81 | 1683.789769
B44_L10_P | Y14 | IO_L10P_AD10P_44 | 66.75 | 67.42 | 387.7745665 | 1292.9 | 1680.674566
B44_L11_N | W11 | IO_L11N_AD9N_44 | 84.773 | 85.625 | 492.4797688 | 1376.05 | 1868.529769
B44_L11_P | W12 | IO_L11P_AD9P_44 | 83.068 | 83.903 | 482.5751445 | 1382.87 | 1865.445145
B44_L12_N | AA12 | IO_L12N_AD8N_44 | 73.274 | 74.011 | 425.6791908 | 1213.53 | 1639.209191
B44_L12_P | Y12 | IO_L12P_AD8P_44 | 68.35 | 69.037 | 397.0722543 | 1241.26 | 1638.332254
差分P和N之间要做等长，等长控制在5mil以内。
B44的信号做等长，等长在300mil以内

Sheet: BANK45
Name | Pin Number | Singals | Min Trace Delay (ps) | Max Trace Delay (ps) | Delay(mils) | Board Length(mils) | Total Length(mils)
B45_L4_N | H12 | IO_L4N_AD12N_45 | 92.283 | 93.21 | 536.1069364 | 828.98 | 1365.086936
B45_L4_P | J12 | IO_L4P_AD12P_45 | 96.704 | 97.676 | 561.7919075 | 806.21 | 1368.001908
B45_L5_N | F10 | IO_L5N_HDGC_45 | 101.595 | 102.616 | 590.2052023 | 765.85 | 1356.055202
B45_L5_P | G11 | IO_L5P_HDGC_45 | 101.321 | 102.34 | 588.6156069 | 774.26 | 1362.875607
B45_L6_N | F11 | IO_L6N_HDGC_45 | 101.099 | 102.115 | 587.3236994 | 962.48 | 1549.803699
B45_L6_P | F12 | IO_L6P_HDGC_45 | 100.614 | 101.626 | 584.5086705 | 964.74 | 1549.248671
B45_L9_N | B10 | IO_L9N_AD11N_45 | 109.906 | 111.01 | 638.4855491 | 855.27 | 1493.755549
B45_L9_P | C11 | IO_L9P_AD11P_45 | 109.407 | 110.507 | 635.5895954 | 860.01 | 1495.599595
B45_L10_N | A10 | IO_L10N_AD10N_45 | 106.2 | 107.268 | 616.9595376 | 855.84 | 1472.799538
B45_L10_P | B11 | IO_L10P_AD10P_45 | 98.351 | 99.34 | 571.3612717 | 899.56 | 1470.921272
B45_L11_N | A11 | IO_L11N_AD9N_45 | 107.782 | 108.865 | 626.1473988 | 860.34 | 1486.487399
B45_L11_P | A12 | IO_L11P_AD9P_45 | 101.509 | 102.529 | 589.7052023 | 897.44 | 1487.145202
B45_L12_N | C12 | IO_L12N_AD8N_45 | 112.71 | 113.842 | 654.7745665 | 833.51 | 1488.284566
B45_L12_P | D12 | IO_L12P_AD8P_45 | 115.803 | 116.967 | 672.7456647 | 817.34 | 1490.085665
差分P和N之间要做等长，等长控制在5mil以内。
B45的信号做等长，等长在300mil以内

Sheet: BANK46
Name | Pin Number | Singals | Min Trace Delay (ps) | Max Trace Delay (ps) | Delay(mils) | Board Length(mils) | Total Length(mils)
B46_L1_N | A15 | IO_L1N_AD11N_46 | 86.831 | 87.704 | 504.4364162 | 959.57 | 1464.006416
B46_L1_P | B15 | IO_L1P_AD11P_46 | 84.298 | 85.145 | 489.7196532 | 975.36 | 1465.079653
B46_L2_N | A14 | IO_L2N_AD10N_46 | 86.941 | 87.814 | 505.0722543 | 909.34 | 1414.412254
B46_L2_P | B14 | IO_L2P_AD10P_46 | 84.527 | 85.377 | 491.0520231 | 920.86 | 1411.912023
B46_L3_N | A13 | IO_L3N_AD9N_46 | 89.472 | 90.371 | 519.7774566 | 886.99 | 1406.767457
B46_L3_P | B13 | IO_L3P_AD9P_46 | 86.909 | 87.782 | 504.8872832 | 901.83 | 1406.717283
B46_L4_N | C13 | IO_L4N_AD8N_46 | 81.669 | 82.489 | 474.4450867 | 960.72 | 1435.165087
B46_L4_P | C14 | IO_L4P_AD8P_46 | 80.093 | 80.898 | 465.2919075 | 967.74 | 1433.031908
B46_L5_N | D14 | IO_L5N_HDGC_AD7N_46 | 76.762 | 77.534 | 445.9421965 | 1007.62 | 1453.562197
B46_L5_P | D15 | IO_L5P_HDGC_AD7P_46 | 76.644 | 77.415 | 445.2572254 | 1007.65 | 1452.907225
B46_L6_N | E13 | IO_L6N_HDGC_AD6N_46 | 80.365 | 81.173 | 466.8728324 | 971.45 | 1438.322832
B46_L6_P | E14 | IO_L6P_HDGC_AD6P_46 | 80.213 | 81.019 | 465.9884393 | 971.61 | 1437.598439
B46_L7_N | F13 | IO_L7N_HDGC_AD5N_46 | 65.509 | 66.167 | 380.566474 | 1068.23 | 1448.796474
B46_L7_P | G13 | IO_L7P_HDGC_AD5P_46 | 66.478 | 67.146 | 386.1965318 | 1067.07 | 1453.266532
B46_L9_N | G14 | IO_L9N_AD3N_46 | 50.338 | 50.844 | 292.433526 | 1149.08 | 1441.513526
B46_L9_P | G15 | IO_L9P_AD3P_46 | 49.184 | 49.679 | 285.7312139 | 1154.38 | 1440.111214
B46_L10_N | H13 | IO_L10N_AD2N_46 | 57.143 | 57.717 | 331.9653179 | 1107.99 | 1439.955318
B46_L10_P | H14 | IO_L10P_AD2P_46 | 50.56 | 51.068 | 293.7225434 | 1145.52 | 1439.242543
B46_L11_N | J14 | IO_L11N_AD1N_46 | 55.376 | 55.933 | 321.7023121 | 1118 | 1439.702312
B46_L11_P | K14 | IO_L11P_AD1P_46 | 68.735 | 69.426 | 399.3092486 | 1042.84 | 1442.149249
B46_L12_N | L13 | IO_L12N_AD0N_46 | 76.748 | 77.519 | 445.8583815 | 1282.36 | 1728.218382
B46_L12_P | L14 | IO_L12P_AD0P_46 | 73.601 | 74.341 | 427.5780347 | 1296.12 | 1723.698035
差分P和N之间要做等长，等长控制在5mil以内。
B46的信号做等长，等长在300mil以内

Sheet: SD
Name | Pin Number | Singals | Min Trace Delay (ps) | Max Trace Delay (ps) | Delay(mils) | 核心板走线长度 | Total
SD_D0 | L20 | PS_MIO46_501 | 48.286 | 48.771 | 280.5115607 | 1454.41 | 1734.921561
SD_D1 | H21 | PS_MIO47_501 | 39.427 | 39.823 | 229.0462428 | 1394.39 | 1623.436243
SD_D2 | J21 | PS_MIO48_501 | 40.323 | 40.728 | 234.2514451 | 1398.85 | 1633.101445
SD_D3 | M18 | PS_MIO49_501 | 74.448 | 75.196 | 432.4971098 | 1539.7 | 1972.19711
SD_CMD | M19 | PS_MIO50_501 | 66.39 | 67.057 | 385.6849711 | 1464.73 | 1850.414971
SD_CLK | L21 | PS_MIO51_501 | 63.203 | 63.838 | 367.1705202 | 1541.41 | 1908.58052

Sheet: Eth1
Name | Pin Number | Singals | Min Trace Delay (ps) | Max Trace Delay (ps) | Delay(mils) | 核心板走线长度 | 总的核心板长度(mils)
PHY1_TXCK | E19 | PS_MIO64_502 | 70.962 | 71.675 | 412.2456647 | 2599.06 | 3011.305665
PHY1_TXD0 | A18 | PS_MIO65_502 | 79.519 | 80.318 | 461.9566474 | 2490.03 | 2951.986647
PHY1_TXD1 | G19 | PS_MIO66_502 | 55.067 | 55.62 | 319.9046243 | 2579.93 | 2899.834624
PHY1_TXD2 | B18 | PS_MIO67_502 | 75.872 | 76.635 | 440.7716763 | 2540.71 | 2981.481676
PHY1_TXD3 | C18 | PS_MIO68_502 | 72.447 | 73.175 | 420.8728324 | 2515.48 | 2936.352832
PHY1_TXCTL | D19 | PS_MIO69_502 | 70.033 | 70.736 | 406.8468208 | 2674.89 | 3081.736821
PHY1_RXCK | C19 | PS_MIO70_502 | 68.703 | 69.394 | 399.1242775 | 2773.96 | 3173.084277
PHY1_RXD0 | B19 | PS_MIO71_502 | 74.938 | 75.691 | 435.3439306 | 2776.94 | 3212.283931
PHY1_RXD1 | G20 | PS_MIO72_502 | 49.937 | 50.439 | 290.1040462 | 2656.82 | 2946.924046
PHY1_RXD2 | G21 | PS_MIO73_502 | 42.266 | 42.691 | 245.5404624 | 2592.95 | 2838.490462
PHY1_RXD3 | D20 | PS_MIO74_502 | 80.008 | 80.812 | 464.7976879 | 2577.87 | 3042.667688
PHY1_RXCTL | A19 | PS_MIO75_502 | 74.492 | 75.241 | 432.7543353 | 2813.3 | 3246.054335

Sheet: ETH2
信号 | PIN | Name | Min Trace Delay (ps) | Max Trace Delay (ps) | Delay(mils) | 核心板走线长度 | Total
PHY2_RXCK | E5 | B66_L14_P | 104.577 | 105.628 | 607.5289017 | 1169.98 | 1777.508902
PHY2_RXCTL | B8 | B66_L22_N | 90.366 | 91.274 | 524.9710983 | 1150.74 | 1675.711098
PHY2_RXD0 | A5 | B66_L19_N | 107.425 | 108.505 | 624.0751445 | 1110.78 | 1734.855145
PHY2_RXD1 | B5 | B66_L19_P | 106.281 | 107.349 | 617.4277457 | 1117.41 | 1734.837746
PHY2_RXD2 | F8 | B66_L17_P | 90.715 | 91.627 | 527 | 1133.11 | 1660.11
PHY2_RXD3 | C9 | B66_L24_P | 84.68 | 85.531 | 491.9393064 | 1168.12 | 1660.059306
PHY2_TXCK | A7 | B66_L21_P | 98.289 | 99.276 | 570.9971098 | 1111.27 | 1682.26711
PHY2_TXCTL | B9 | B66_L24_N | 87.479 | 88.358 | 508.199422 | 1154.93 | 1663.129422
PHY2_TXD3 | A8 | B66_L23_N | 87.757 | 88.639 | 509.8150289 | 1141.39 | 1651.205029
PHY2_TXD2 | A9 | B66_L23_P | 83.509 | 84.349 | 485.1387283 | 1164.63 | 1649.768728
PHY2_TXD1 | D9 | B66_L18_N | 93.924 | 94.868 | 545.6416185 | 1181.62 | 1727.261618
PHY2_TXD0 | E9 | B66_L18_P | 102.038 | 103.063 | 592.7774566 | 1138.05 | 1730.827457

Sheet: USB
Name | Pin Number | Singals | Min Trace Delay (ps) | Max Trace Delay (ps) | Delay(mils) | 核心板走线长度 | TOTAL
USB_CLK | G18 | PS_MIO52_502 | 52.926 | 53.458 | 307.4682081 | 2342.43 | 2649.898208
USB_DIR | D16 | PS_MIO53_502 | 76.645 | 77.416 | 445.2630058 | 2289.8 | 2735.063006
USB_DATA2 | F17 | PS_MIO54_502 | 54.969 | 55.521 | 319.3352601 | 2427.98 | 2747.31526
USB_NXT | B16 | PS_MIO55_502 | 85.663 | 86.524 | 497.650289 | 2549.5 | 3047.150289
USB_DATA0 | C16 | PS_MIO56_502 | 82.092 | 82.917 | 476.9046243 | 2372.03 | 2848.934624
USB_DATA1 | A16 | PS_MIO57_502 | 89.485 | 90.385 | 519.8554913 | 2460.3 | 2980.155491
USB_STP | F18 | PS_MIO58_502 | 56.334 | 56.9 | 327.265896 | 2269.17 | 2596.435896
USB_DATA3 | E17 | PS_MIO59_502 | 85.019 | 85.873 | 493.9075145 | 2520.81 | 3014.717514
USB_DATA4 | C17 | PS_MIO60_502 | 77.536 | 78.315 | 450.4364162 | 2446.07 | 2896.506416
USB_DATA5 | D17 | PS_MIO61_502 | 81.269 | 82.086 | 472.1242775 | 2508.03 | 2980.154277
USB_DATA6 | A17 | PS_MIO62_502 | 84.887 | 85.74 | 493.1416185 | 2566.95 | 3060.091618
USB_DATA7 | E18 | PS_MIO63_502 | 79.678 | 80.479 | 462.8815029 | 2511.95 | 2974.831503
