alinxalinx/ACU2CG_ACU3EG_ACU4EV_ACU5EV/STEP_Models/ACU2CG-E_size_structure.dxf

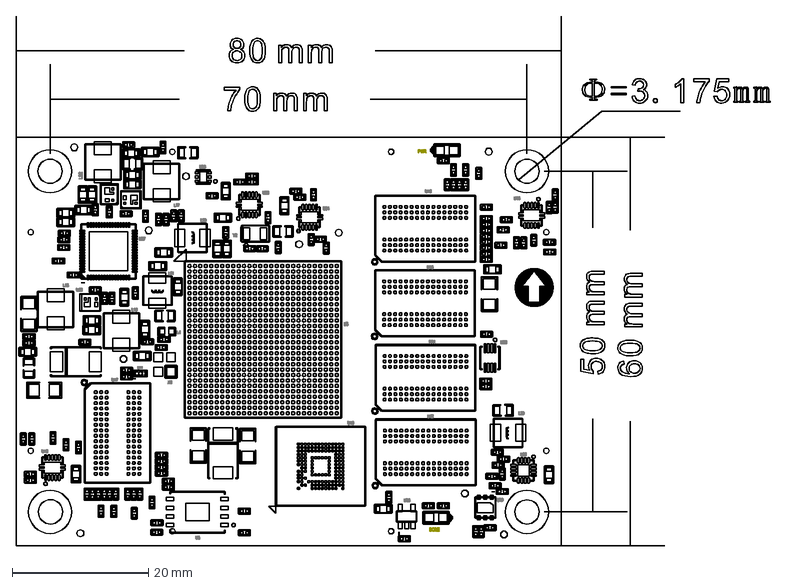
[picture p5: CAD file, 2023-02-10]
STEP_Models/ACU2CG-E_size_structure.dxf
110.7 x 77.8 mm
