alinxalinx/ACU2CG_ACU3EG_ACU4EV_ACU5EV/STEP_Models/ACU2CG-E_size_structure.pdf

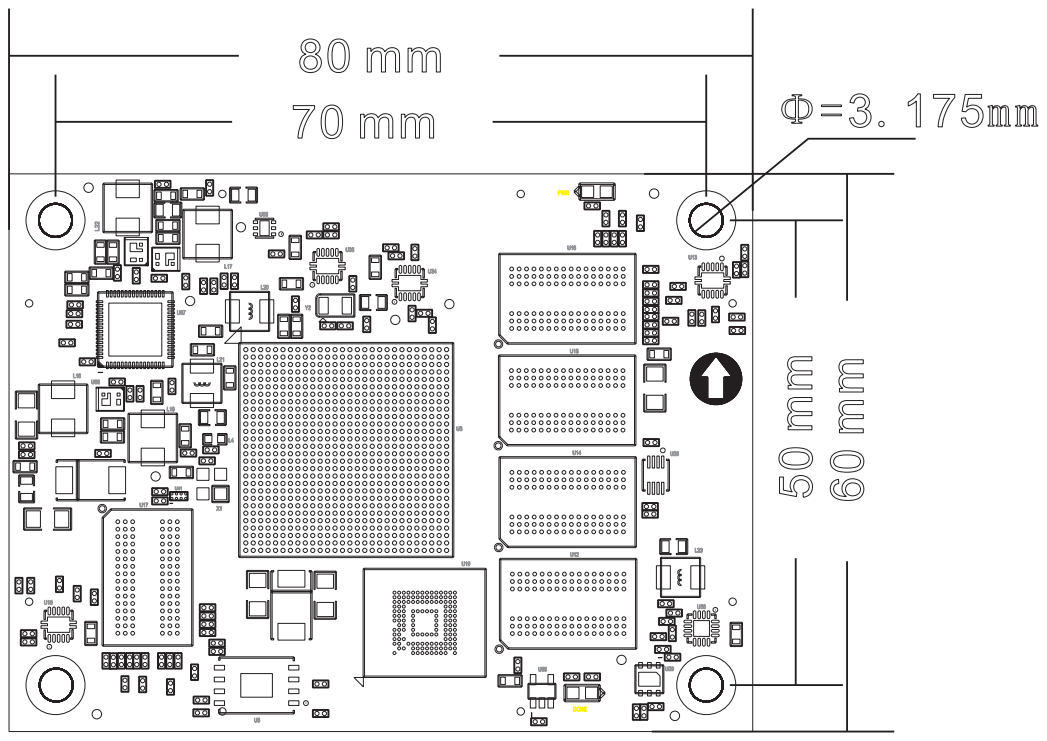
[picture p74: page 1]
